sDawid98/LowPowerSensorMesh/STM32_WPAN/App/custom_app.c

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

/* Includes ------------------------------------------------------------------*/
#include "main.h"
#include "app_common.h"
#include "dbg_trace.h"
#include "ble.h"
#include "custom_app.h"
#include "custom_stm.h"
#include "stm32_seq.h"

/* USER CODE BEGIN Includes */
#include "adc.h"
#include "i2c.h"
#include "LIS3DH.h"
#include "PT100.h"
/* USER CODE END Includes */

typedef struct
{
	/* LPSMdata */
	uint8_t               Temperaturedata_Notification_Status;
	uint8_t               Wibrationdata_Notification_Status;
	uint16_t              ConnectionHandle;
} Custom_App_Context_t;

/**
 * START of Section BLE_APP_CONTEXT
 */

PLACE_IN_SECTION("BLE_APP_CONTEXT") static Custom_App_Context_t Custom_App_Context;

/**
 * END of Section BLE_APP_CONTEXT
 */

/* USER CODE BEGIN PV */
uint8_t UpdateCharData[247];
uint8_t NotifyCharData[247];

/* USER CODE END PV */

/* LPSMdata */
static void Custom_Temperaturedata_Update_Char(void);
static void Custom_Temperaturedata_Send_Notification(void);
static void Custom_Wibrationdata_Update_Char(void);
static void Custom_Wibrationdata_Send_Notification(void);

/* USER CODE BEGIN PFP */
void SystemInitialize(void)
{
	HAL_ADC_Start_DMA(&hadc1, (uint32_t *)PT100AdcBuffor , PT100_ADC_BUFFOR_SIZE);
	AccInit(&hi2c1);

	PT100Init();
}
void SendDataBle(void)
{
	static uint32_t SendTempDatTim, SendAccDatTim = 0;

	if(HAL_GetTick() - SendTempDatTim > TEMP_SEND_TIME_INTERVAL)
	{
		PT100CalculateTemperature();

		NotifyCharData[0] = TempSensor.TempToSend;
		NotifyCharData[1] = TempSensor.TempToSend >> 8;

		SendTempDatTim = HAL_GetTick();
		Custom_Temperaturedata_Send_Notification();
	}
	if(HAL_GetTick() - SendAccDatTim > ACC_GET_MEAS_INTERVAL)
	{
		CalculateMagnitude();

		NotifyCharData[2] = Accel.MagnitudeToSend;
		NotifyCharData[3] = Accel.MagnitudeToSend >> 8;

		SendAccDatTim = HAL_GetTick();
		Custom_Wibrationdata_Send_Notification();
	}

	UTIL_SEQ_SetTask(1 << CFG_BLE_SEND_TASK, CFG_SCH_PRIO_0);
}
void AccelerometerTask(void)
{
	static uint32_t AccGetMeasTimer = 0;

	if(HAL_GetTick() - AccGetMeasTimer > ACC_GET_MEAS_INTERVAL)
	{
		AccGetMeasTimer = HAL_GetTick();

		AccReadAllAxisData();
	}
	UTIL_SEQ_SetTask(1 << CFG_TASK_ACCELEROMETER, CFG_SCH_PRIO_0); //Scheduler will run it once
}
/* USER CODE END PFP */

/* Functions Definition ------------------------------------------------------*/
void Custom_STM_App_Notification(Custom_STM_App_Notification_evt_t *pNotification)
{
	switch(pNotification->Custom_Evt_Opcode)
	{
	/* USER CODE BEGIN CUSTOM_STM_App_Notification_Custom_Evt_Opcode */

	/* USER CODE END CUSTOM_STM_App_Notification_Custom_Evt_Opcode */

	/* LPSMdata */
	case CUSTOM_STM_TEMPERATUREDATA_READ_EVT:
		/* USER CODE BEGIN CUSTOM_STM_TEMPERATUREDATA_READ_EVT */

		/* USER CODE END CUSTOM_STM_TEMPERATUREDATA_READ_EVT */
		break;

	case CUSTOM_STM_TEMPERATUREDATA_NOTIFY_ENABLED_EVT:
		/* USER CODE BEGIN CUSTOM_STM_TEMPERATUREDATA_NOTIFY_ENABLED_EVT */

		/* USER CODE END CUSTOM_STM_TEMPERATUREDATA_NOTIFY_ENABLED_EVT */
		break;

	case CUSTOM_STM_TEMPERATUREDATA_NOTIFY_DISABLED_EVT:
		/* USER CODE BEGIN CUSTOM_STM_TEMPERATUREDATA_NOTIFY_DISABLED_EVT */

		/* USER CODE END CUSTOM_STM_TEMPERATUREDATA_NOTIFY_DISABLED_EVT */
		break;

	case CUSTOM_STM_WIBRATIONDATA_READ_EVT:
		/* USER CODE BEGIN CUSTOM_STM_WIBRATIONDATA_READ_EVT */

		/* USER CODE END CUSTOM_STM_WIBRATIONDATA_READ_EVT */
		break;

	case CUSTOM_STM_WIBRATIONDATA_NOTIFY_ENABLED_EVT:
		/* USER CODE BEGIN CUSTOM_STM_WIBRATIONDATA_NOTIFY_ENABLED_EVT */

		/* USER CODE END CUSTOM_STM_WIBRATIONDATA_NOTIFY_ENABLED_EVT */
		break;

	case CUSTOM_STM_WIBRATIONDATA_NOTIFY_DISABLED_EVT:
		/* USER CODE BEGIN CUSTOM_STM_WIBRATIONDATA_NOTIFY_DISABLED_EVT */

		/* USER CODE END CUSTOM_STM_WIBRATIONDATA_NOTIFY_DISABLED_EVT */
		break;

	default:
		/* USER CODE BEGIN CUSTOM_STM_App_Notification_default */

		/* USER CODE END CUSTOM_STM_App_Notification_default */
		break;
	}
	return;
}

void Custom_APP_Notification(Custom_App_ConnHandle_Not_evt_t *pNotification)
{
	switch(pNotification->Custom_Evt_Opcode)
	{
	/* USER CODE BEGIN CUSTOM_APP_Notification_Custom_Evt_Opcode */

	/* USER CODE END P2PS_CUSTOM_Notification_Custom_Evt_Opcode */
	case CUSTOM_CONN_HANDLE_EVT :
		break;

	case CUSTOM_DISCON_HANDLE_EVT :
		break;

	default:
		/* USER CODE BEGIN CUSTOM_APP_Notification_default */

		/* USER CODE END CUSTOM_APP_Notification_default */
		break;
	}

	return;
}

void Custom_APP_Init(void)
{
	return;
}

/*************************************************************
 *
 * LOCAL FUNCTIONS
 *
 *************************************************************/

/* LPSMdata */
void Custom_Temperaturedata_Update_Char(void) /* Property Read */
{
	Custom_STM_App_Update_Char(CUSTOM_STM_TEMPERATUREDATA, (uint8_t *)UpdateCharData);
	/* USER CODE BEGIN Temperaturedata_UC*/

	/* USER CODE END Temperaturedata_UC*/
	return;
}

void Custom_Temperaturedata_Send_Notification(void) /* Property Notification */
{
	if(Custom_App_Context.Temperaturedata_Notification_Status)
	{
		Custom_STM_App_Update_Char(CUSTOM_STM_TEMPERATUREDATA, (uint8_t *)NotifyCharData);
		/* USER CODE BEGIN Temperaturedata_NS*/

		/* USER CODE END Temperaturedata_NS*/
	}
	else
	{
		APP_DBG_MSG("-- CUSTOM APPLICATION : CAN'T INFORM CLIENT -  NOTIFICATION DISABLED\n ");
	}
	return;
}

void Custom_Wibrationdata_Update_Char(void) /* Property Read */
{
	Custom_STM_App_Update_Char(CUSTOM_STM_WIBRATIONDATA, (uint8_t *)UpdateCharData);
	/* USER CODE BEGIN Wibrationdata_UC*/

	/* USER CODE END Wibrationdata_UC*/
	return;
}

void Custom_Wibrationdata_Send_Notification(void) /* Property Notification */
{
	if(Custom_App_Context.Wibrationdata_Notification_Status)
	{
		Custom_STM_App_Update_Char(CUSTOM_STM_WIBRATIONDATA, (uint8_t *)NotifyCharData+2);
		/* USER CODE BEGIN Wibrationdata_NS*/

		/* USER CODE END Wibrationdata_NS*/
	}
	else
	{
		APP_DBG_MSG("-- CUSTOM APPLICATION : CAN'T INFORM CLIENT -  NOTIFICATION DISABLED\n ");
	}
	return;
}

/* USER CODE BEGIN FD_LOCAL_FUNCTIONS*/

/* USER CODE END FD_LOCAL_FUNCTIONS*/
