sDawid98/LowPowerSensorMesh/Core/VirtualEEPROM/ee.h

#ifndef __EEPROM_H
#define __EEPROM_H


#ifdef __cplusplus
 extern "C" {
#endif

#include <stdbool.h>
#include "main.h"
#include "stm32wb55xx.h"

//################################################################################################################
bool      ee_init(void);
bool      ee_format(bool keepRamData);
bool      ee_read(uint32_t startVirtualAddress, uint32_t len, uint8_t* data);
bool      ee_write(uint32_t startVirtualAddress, uint32_t len, uint8_t* data);
bool      ee_writeToRam(uint32_t startVirtualAddress, uint32_t len, uint8_t* data); //  only use when _EE_USE_RAM_BYTE is enabled
bool      ee_commit(void);  //  only use when _EE_USE_RAM_BYTE is enabled
uint32_t  ee_maxVirtualAddress(void);

//################################################################################################################

#ifdef __cplusplus
}
#endif

#endif
