sDawid98/LowPowerSensorMesh/(commit log)

2022-05-05 Device advertises and connects
2022-05-05 UART debug traces added
2022-05-05 writable characteristic added, toggle led when msg is sent from ST Tool box app
2022-05-13 .h .c to accelerometer added, defines made
2022-05-15 reading and writing accelerometer functions fixed
    [LPSM Debug.cfg]
2022-05-16 SPI config properly - checked on saleae logic analyzer
2022-05-17 accelerometer i2c config added
2022-05-17 accelerometer i2c xyz axis value read correct
    [LIS3DH.c, LIS3DH.h]
2022-05-31 i2c acc added
2022-05-31 adc configured for end of conversion, ADC conv finished routine need to be added to HAL_DMA_IRQHandler
2022-06-03 spi removed, accelerometer task added
2022-06-05 adc slowed, pt100 calib routine partly added
2022-06-05 erease FLASH functions works. Ceoaff flash wirte and read needs to be added
2022-06-05 pt100 adc routine added to DMA handler
2022-06-07 sending int16 between stm32 and phone app works
2022-06-07 temperatute measure calibrated and sending it throughout ble works
2022-06-07 functions names chagned for correct ones declared in pt100.h
    [PT100.c, PT100.h]
