sDawid98/LowPowerSensorMesh/(notices)

Notices in the files:
Core/Inc/app_conf.h:
Copyright (c) 2022 STMicroelectronics.
All rights reserved.
This software is licensed under terms that can be found in the LICENSE file
